fpozzana/RISC-V/src/Components/IRAM/asm/asm_test/operazioni.jpg

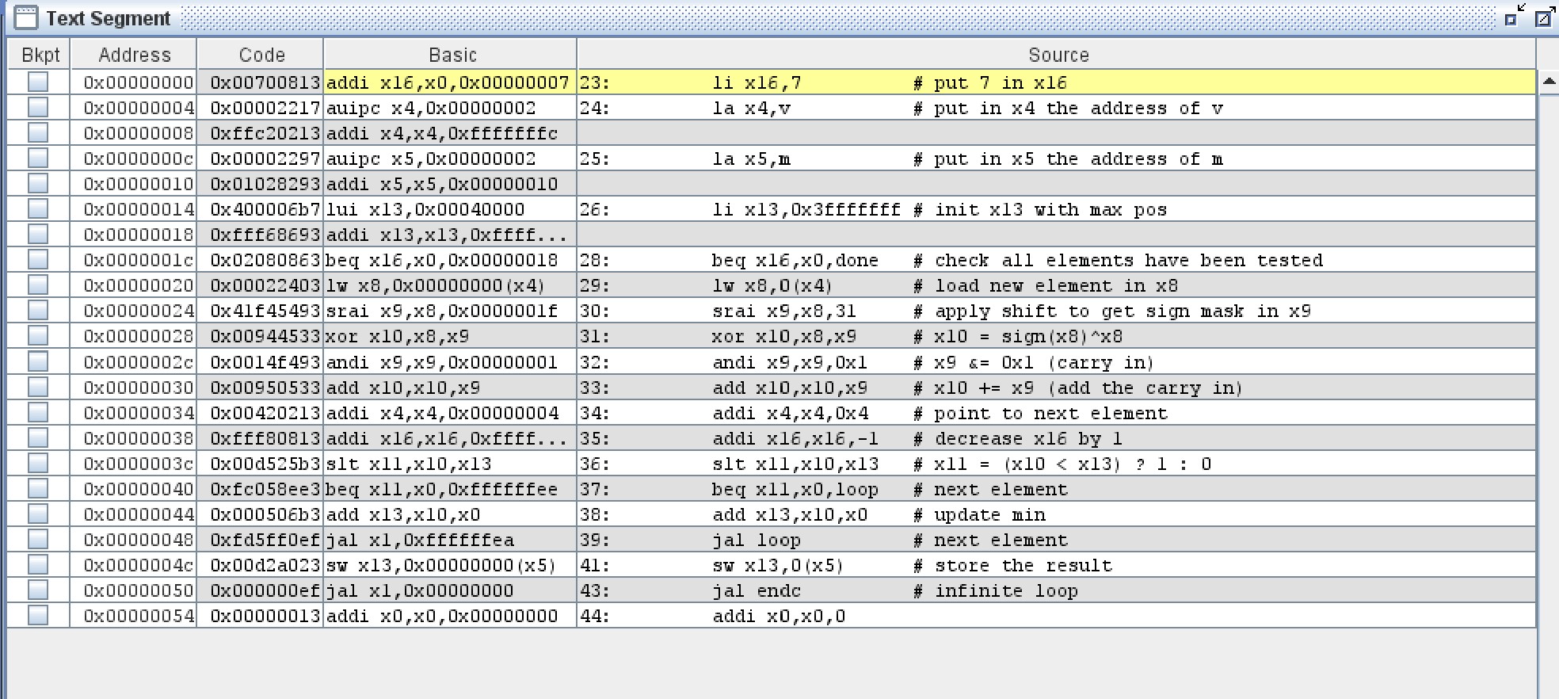
src/Components/IRAM/asm/asm_test/operazioni.jpg
